tmcr1234/CNC/(list of files, drawings)

Other design files:
CNC 3.fzz
